berndporr/attys/attys_fw/README.md

# attys_fw

This is the firmware for the Attys.

## Requirements

  - MSP430 Launchpad
  - Linux system
  - mspdebug
  - msp gcc packages

## How to install

  - connect the programmer to the SBW pins
  - type "make"
  - mspdebug rf2500
  - prog attys_fw.elf
