berndporr/attys/attys_hardware/attys_bom.xls

BOM | bt-bio-1.1
 |  | Qty | Value | Device | Package | Parts | Description | Farnell
 |  | 1 |  | MA03-1 | MA03-1 | SV1 | PIN HEADER | 3417657
 |  | 8 | 100nF | C-EUC0603 | C0603 | C1, C3, C5, C6, C9, C10, C13, C28 | CAPACITOR, European symbol | 1759122
 |  | 1 | 10nF | C-EUC0603 | C0603 | C8 | CAPACITOR, European symbol | 1759102
 |  | 7 | 10uF | C-EUC1206 | C1206 | C2, C7, C11, C12, C14, C20, C24 | CAPACITOR, European symbol | 1458919
 |  | 2 | 1uF | C-EUC0603 | C0603 | C15, C16 | CAPACITOR, European symbol | 1759408
 |  | 10 | 2.2K | R-EU_R0603 | R0603 | R2, R10, R12, R13, R16, R17, R18, R19, R21, R22 | RESISTOR, European symbol | 1469765
 |  | 2 | 33K | R-EU_R0603 | R0603 | R1, R20 | RESISTOR, European symbol | 1469801
 |  | 2 | 4.7nF | C-EUC0603 | C0603 | C17, C18 | CAPACITOR, European symbol | 2320809
 |  | 4 | 4.7uF | CPOL-EUSMCC | SMC_C | C23, C25, C26, C27 | POLARIZED CAPACITOR, European symbol | 1754202
 |  | 4 | 47pF | C-EUC0603 | C0603 | C4, C19, C21, C22 | CAPACITOR, European symbol | 1759062
 |  | 1 | 47uH | R-EU_R0805 | R0805 | L1 | RESISTOR, European symbol | 2215655
 |  | 4 | 4MMCONNECT | 4MMCONNECT | 4MMCONNECT | U$5, U$7, U$9, U$10 |  | 1101130
 |  | 5 | 51K | R-EU_R0603 | R0603 | R4, R5, R6, R9, R23 | RESISTOR, European symbol | 2447393
 |  | 2 | 53047-03 | 53047-03 | 53047-03 | X1, X3 | CONNECTOR | 1022276
 |  | 1 | ADP121-AUJZ18R7 | ADP121-AUJZ33R7 | SOT95P280X100-5N | U4 | 150 mA, Low Quiescent Current, CMOS Linear Regulator | 2457162
 |  | 1 | ADP121-AUJZ33R7 | ADP121-AUJZ33R7 | SOT95P280X100-5N | U1 | 150 mA, Low Quiescent Current, CMOS Linear Regulator | 2074869
 |  | 1 | ADS1292RIPBS | ADS1292R | TQFP-32 | ADS1292R |  | 3116601
 |  | 1 | BLUE | LEDCHIPLED_0805 | CHIPLED_0805 | LED1 | LED | 1716765
 |  | 2 | GREEN | LEDCHIPLED_0805 | CHIPLED_0805 | LED5, LED6 | LED | 2112116
 |  | 1 | LM2664/NOPB | LM2664 | SOT-23-5 | U$12 |  | 3123021
 |  | 1 | LSM9DS1 | LSM9DS1 | LGA24-8X4 | U5 | LSM9DS1 3D accelerometer, gyroscope & magnetometer | 2532383
 |  | 1 | MCP73837-FCI/UN | MCP73837 | MSOP10 | U2 |  | 1675426
 |  | 1 | MINI-USB-SHIELD-UX60-MB-5ST | MINI-USB-SHIELD-UX60-MB-5ST | UX60-MB-5ST | X2 | MINI USB Connector | 2293774
 |  | 1 | MSP430G2553 | MSP430G2553 | TSSOP20 | U$4 |  | 2325745
 |  | 1 | RED | LEDCHIPLED_0805 | CHIPLED_0805 | LED2 | LED | 2099241
 |  | 1 | RN42 | Bluetooth module | RN42 | U$3 |  | 2678457
 |  | 1 | TL36YO | TL36YO | TL3XYO | S1 | TINY SWITCH ON - ON | 1550095
 |  | 6 | VDR,4V | R-EU_R0805 | R0805 | R3, R7, R8, R11, R14, R15 | RESISTOR, European symbol | 8832463
 |  | 1 | Vbat | JP1E | JP1 | VBAT | JUMPER | CN09983
