berndporr/attys/attys_hardware/eagle/attys.brd

## EAGLE design attys_hardware/eagle/attys.brd (2026-11-03)

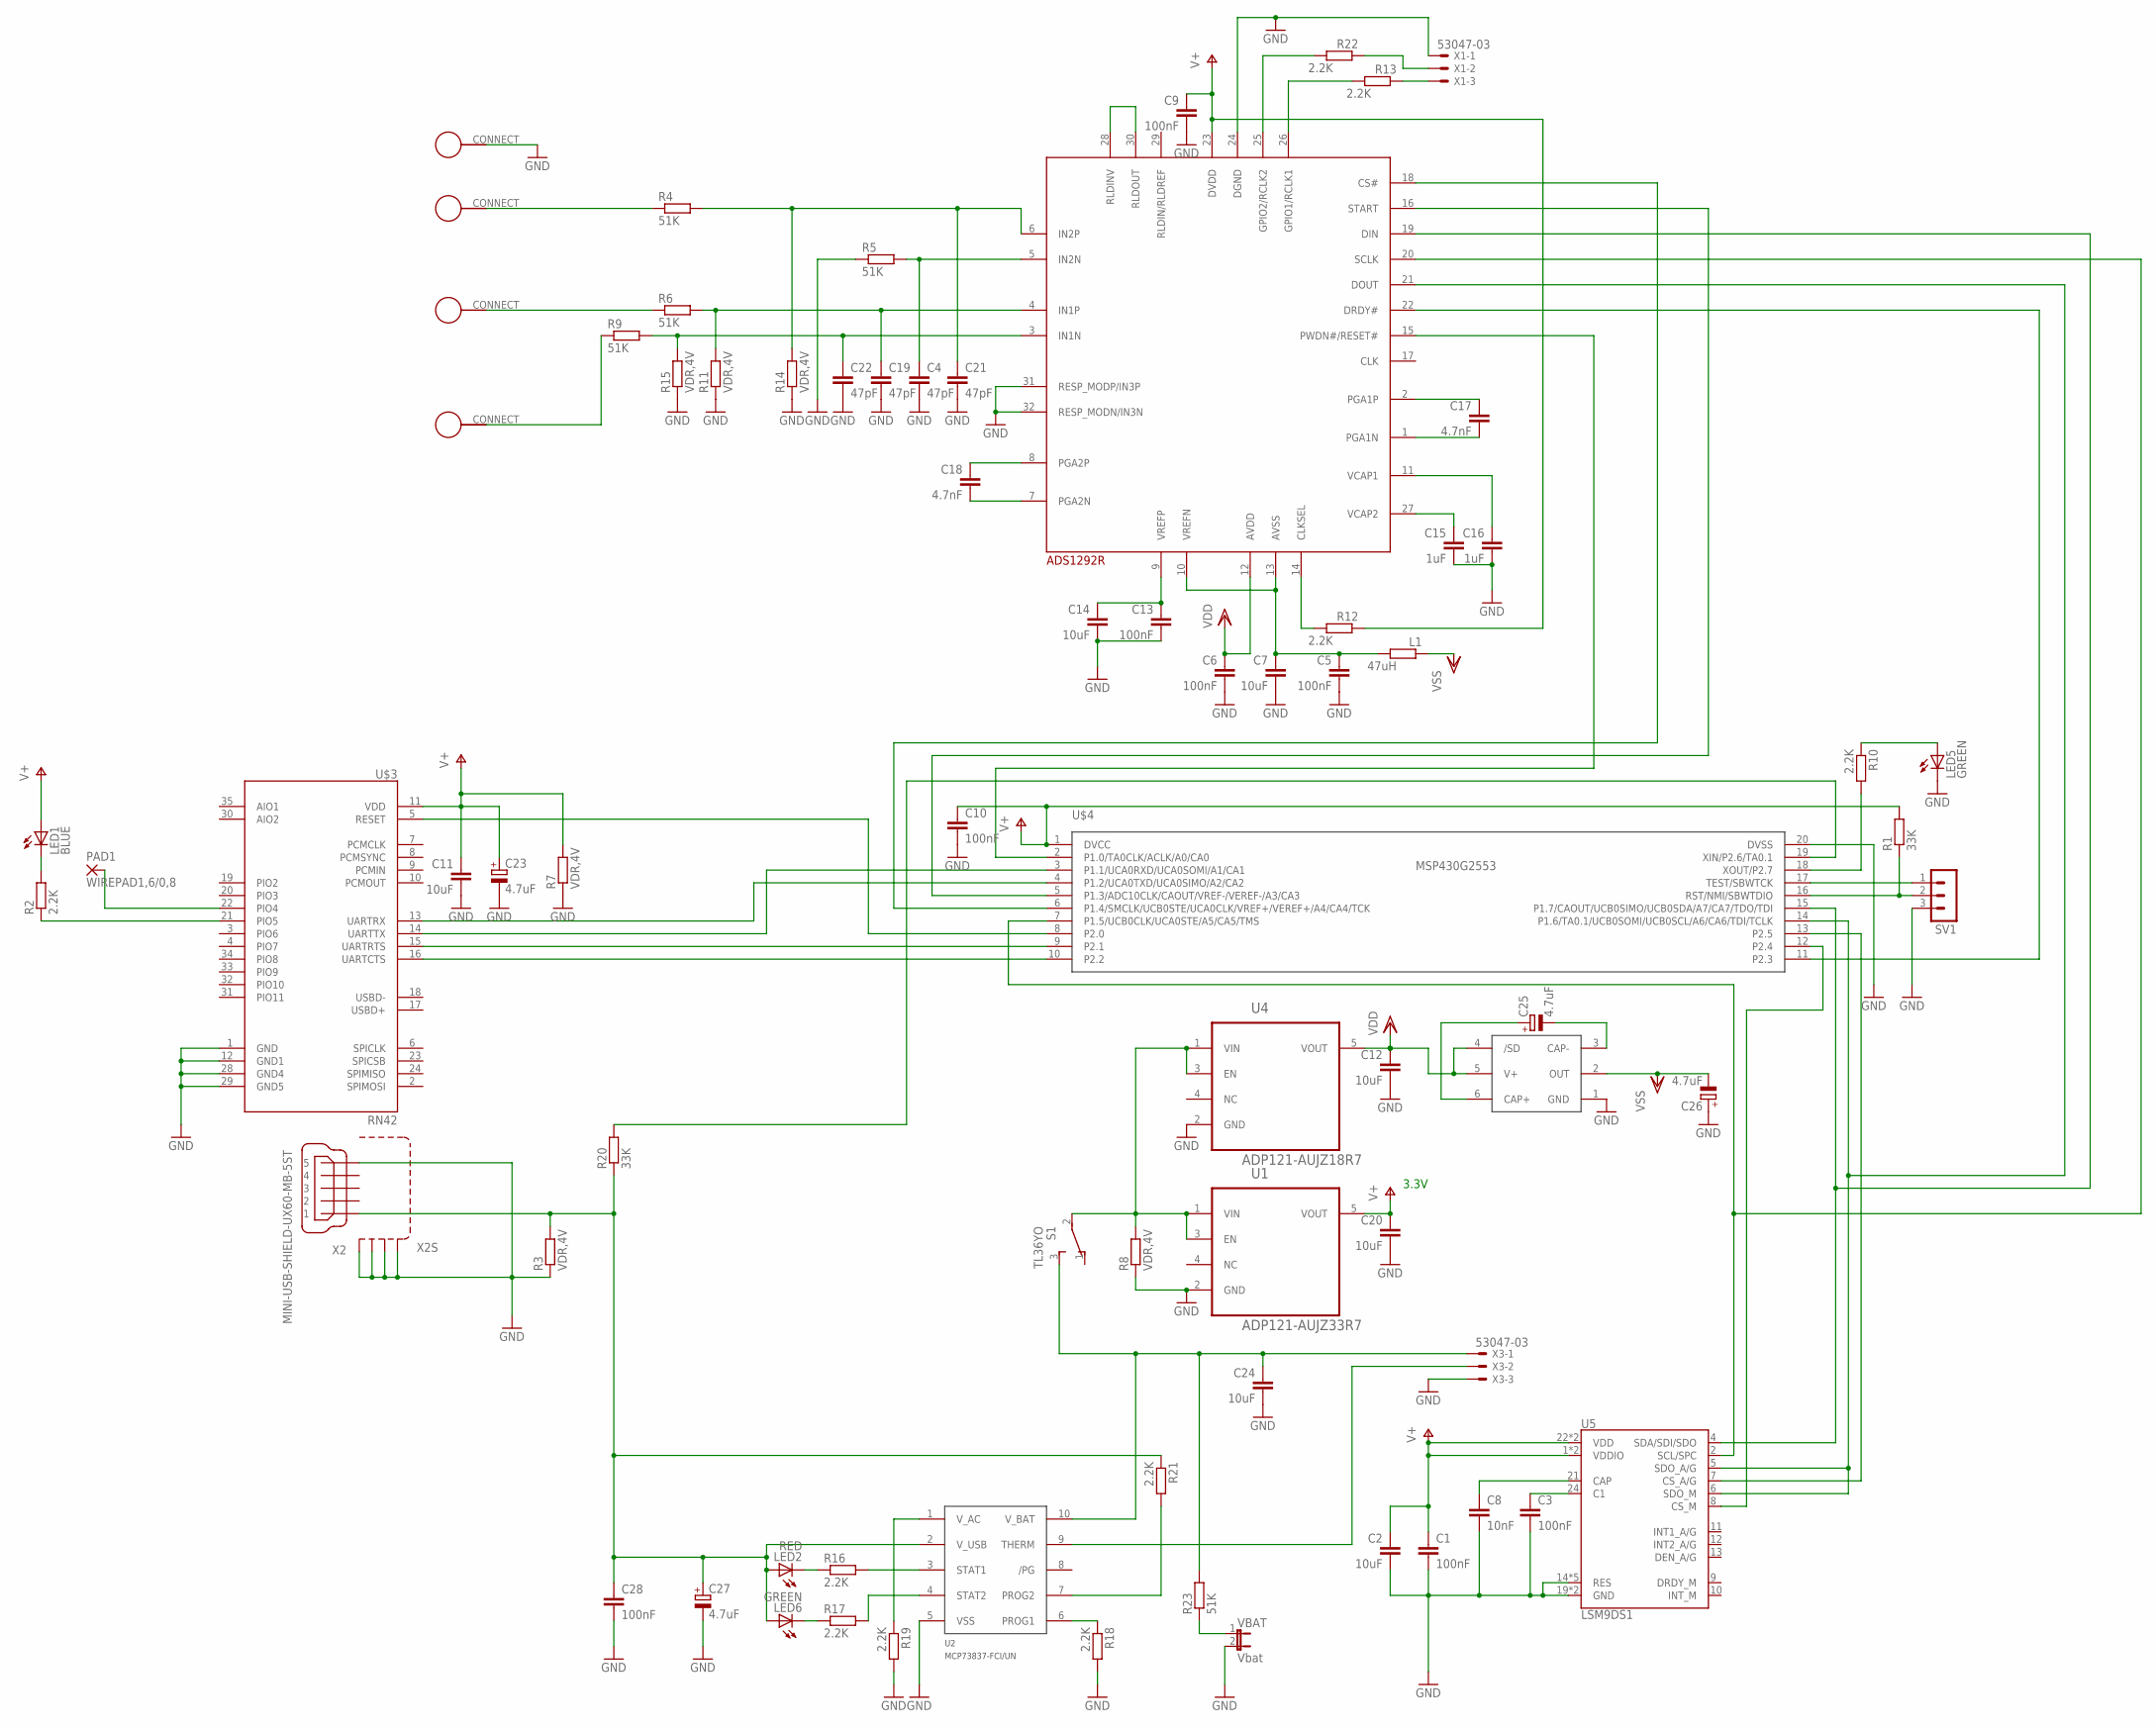
[picture p3: schematic attys.sch]

Parts:
ADS1292R: ADS1292R; TQFP-32
C1, C3, C5, C6, C9, C10, C13, C28: 100nF; C0603
C2, C7, C11, C12, C14, C20, C24: 10uF; C1206
C4, C19, C21, C22: 47pF; C0603
C8: 10nF; C0603
C15, C16: 1uF; C0603
C17, C18: 4.7nF; C0603
C23, C25, C26, C27: 4.7uF; SMC_C
L1: 47uH; R0805
LED1: BLUE; CHIPLED_0805
LED2: RED; CHIPLED_0805
LED5, LED6: GREEN; CHIPLED_0805
PAD1: WIREPAD1,6/0,8; 1,6/0,8
R1, R20: 33K; R0603
R2, R10, R12, R13, R16, R17, R18, R19, R21, R22: 2.2K; R0603
R3, R7, R8, R11, R14, R15: VDR,4V; R0805
R4, R5, R6, R9, R23: 51K; R0603
S1: TL36YO; TL3XYO
SV1: MA03-1
U1: ADP121-AUJZ33R7; SOT95P280X100-5N
U2: MCP73837-FCI/UN; MSOP10
U4: ADP121-AUJZ18R7; SOT95P280X100-5N
U5: LSM9DS1; LGA24-8X4
U$3: RN42; SPARKFUN_RN41
U$4: MSP430G2553; TSSOP20
U$5, U$7, U$9, U$10: 4MMCONNECT
U$12: LM2664; SOT-23-5
VBAT: Vbat; JP1
X1, X3: 53047-03
X2: MINI-USB-SHIELD-UX60-MB-5ST; UX60-MB-5ST

Connections:
+5V: C27.+, C28.1, LED2.A, LED6.A, R3.2, R20.1, R21.1, U2.2 (V_USB), X2.1
CS/: U5.8 (CS_M), U$4.12 (P2.4)
ECG_/CS: ADS1292R.18 (CS#), U$4.6 (P1.4/SMCLK/UCB0STE/UCA0CLK/VREF+/VEREF+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)
ECG_/DRDY: ADS1292R.22 (DRDY#), U$4.11 (P2.3)
ECG_START: ADS1292R.16 (START), U$4.5 (P1.3/ADC10CLK/CAOUT/VREF-/VEREF-/A3/CA3)
GND: ADS1292R.24 (DGND), ADS1292R.31 (RESP_MODP/IN3P), ADS1292R.32 (RESP_MODN/IN3N), C1.2, C2.2, C3.2, C4.2, C5.2, C6.2, C7.2, C8.2, C9.2, C10.2, C11.2, C12.2, C13.2, C14.2, C15.2, C16.2, C19.2, C20.2, C21.2, C22.2, C23.-, C24.2, C26.+, C27.-, C28.2, LED5.C, R3.1, R5.1, R7.1, R8.1, R11.1, R14.1, R15.1, R18.2, R19.2, SV1.3, U1.2 (GND), U2.5 (VSS), U4.2 (GND), U5.14 (RES), U5.15 (RES), U5.16 (RES), U5.17 (RES), U5.18 (RES), U5.19 (GND), U5.20 (GND), U$3.1 (GND), U$3.12 (GND1), U$3.28 (GND4), U$3.29 (GND5), U$4.20 (DVSS), U$5.CONNECT, U$12.1 (GND), VBAT.2, X1.1, X2.5, X2.M1 (S1), X2.M2 (S2), X2.M3 (S3), X2.M4 (S4), X3.3
unnamed: R1.1, SV1.2, U$4.16 (RST/NMI/SBWTDIO)
unnamed: U$3.13 (UARTRX), U$4.4 (P1.2/UCA0TXD/UCA0SIMO/A2/CA2)
unnamed: ADS1292R.28 (RLDINV), ADS1292R.30 (RLDOUT)
unnamed: ADS1292R.5 (IN2N), C4.1, R5.2
unnamed: SV1.1, U$4.17 (TEST/SBWTCK)
unnamed: U$3.14 (UARTTX), U$4.3 (P1.1/UCA0RXD/UCA0SOMI/A1/CA1)
unnamed: U$3.15 (UARTRTS), U$4.9 (P2.1)
unnamed: U$3.16 (UARTCTS), U$4.10 (P2.2)
unnamed: U$3.5 (RESET), U$4.8 (P2.0)
unnamed: R2.1, U$3.21 (PIO5)
unnamed: R8.2, S1.2, U1.1 (VIN), U1.3 (EN), U4.1 (VIN), U4.3 (EN)
unnamed: ADS1292R.10 (VREFN), ADS1292R.13 (AVSS), C5.1, C7.1, L1.2
unnamed: PAD1.1, U$3.22 (PIO4)
unnamed: R10.2, U$4.18 (XOUT/P2.7)
unnamed: LED5.A, R10.1
unnamed: LED1.C, R2.2
unnamed: ADS1292R.25 (GPIO2/RCLK2), R22.2
unnamed: ADS1292R.9 (VREFP), C13.1, C14.1
unnamed: ADS1292R.27 (VCAP2), C15.1
unnamed: ADS1292R.26 (GPIO1/RCLK1), R13.2
unnamed: ADS1292R.11 (VCAP1), C16.1
unnamed: R20.2, U$4.19 (XIN/P2.6/TA0.1)
unnamed: ADS1292R.15 (PWDN#/RESET#), U$4.2 (P1.0/TA0CLK/ACLK/A0/CA0)
unnamed: U5.7 (CS_A/G), U$4.13 (P2.5)
unnamed: C3.1, U5.24 (C1)
unnamed: C8.1, U5.21 (CAP)
unnamed: R13.1, X1.3
unnamed: R22.1, X1.2
unnamed: R23.1, VBAT.1
unnamed: ADS1292R.2 (PGA1P), C17.1
unnamed: ADS1292R.1 (PGA1N), C17.2
unnamed: ADS1292R.8 (PGA2P), C18.1
unnamed: ADS1292R.7 (PGA2N), C18.2
unnamed: ADS1292R.14 (CLKSEL), R12.2
unnamed: ADS1292R.6 (IN2P), C21.1, R4.2, R14.2
unnamed: ADS1292R.3 (IN1N), C22.1, R9.2, R15.2
unnamed: ADS1292R.4 (IN1P), C19.1, R6.2, R11.2
unnamed: R4.1, U$7.CONNECT
unnamed: R9.1, U$10.CONNECT
unnamed: R6.1, U$9.CONNECT
unnamed: C24.1, R23.2, S1.3 (S), U2.10 (V_BAT), X3.1
unnamed: C25.+, U$12.6 (CAP+)
unnamed: C25.-, U$12.3 (CAP-)
unnamed: R16.2, U2.3 (STAT1)
unnamed: LED6.C, R17.1
unnamed: R17.2, U2.4 (STAT2)
unnamed: LED2.C, R16.1
unnamed: R18.1, U2.6 (PROG1)
unnamed: U2.9 (THERM), X3.2
unnamed: R19.1, U2.1 (V_AC)
unnamed: R21.2, U2.7 (PROG2)
SPI_CLK: ADS1292R.20 (SCLK), U5.2 (SCL/SPC), U$4.7 (P1.5/UCB0CLK/UCA0STE/A5/CA5/TMS)
SPI_MISO: ADS1292R.21 (DOUT), U5.5 (SDO_A/G), U5.6 (SDO_M), U$4.14 (P1.6/TA0.1/UCB0SOMI/UCB0SCL/A6/CA6/TDI/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)
SPI_MOSI: ADS1292R.19 (DIN), U5.4 (SDA/SDI/SDO), U$4.15 (P1.7/CAOUT/UCB0SIMO/UCB0SDA/A7/CA7/TDO/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)
V+: ADS1292R.23 (DVDD), C1.1, C2.1, C9.1, C10.1, C11.1, C20.1, C23.+, LED1.A, R1.2, R7.2, R12.1, U1.5 (VOUT), U5.1 (VDDIO), U5.3 (VDDIO), U5.22 (VDD), U5.23 (VDD), U$3.11 (VDD), U$4.1 (DVCC)
VDD: ADS1292R.12 (AVDD), C6.1, C12.1, U4.5 (VOUT), U$12.4 (/SD), U$12.5 (V+)
VSS: C26.-, L1.1, U$12.2 (OUT)

Notes on the sheet:
3.3V

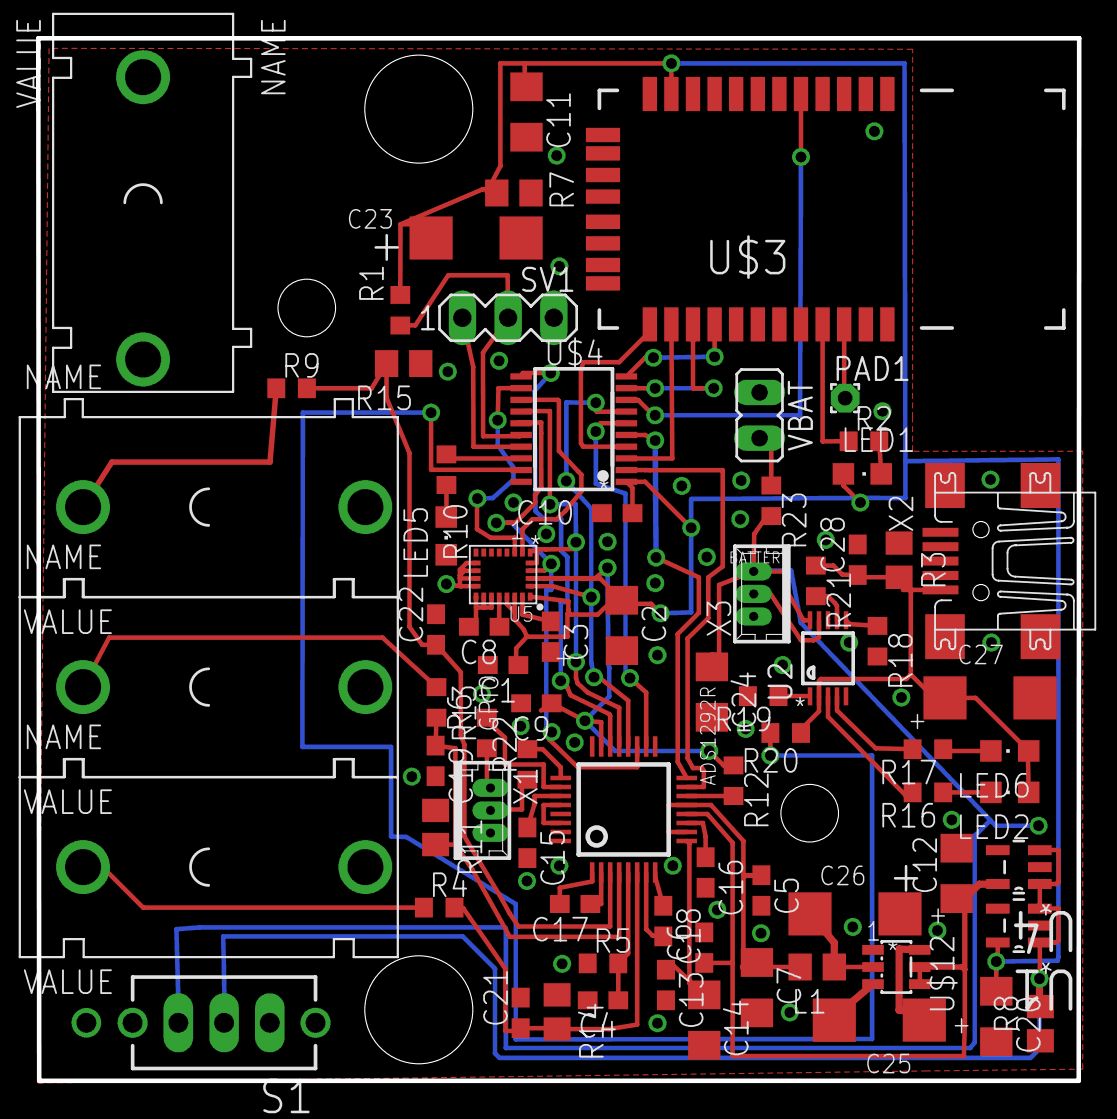
[picture p4: board attys.brd from above]

Board: 2 copper layers, 57.8 x 57.9 mm, 75 parts (0 on the bottom side), 63 nets.
