berndporr/attys/(commit log)

2026-11-03 Converted to kicad
    [attys.brd, attys.kicad_pcb, attys.kicad_sch, attys.sch, attys_bom.ods, attys_bom.xls]
2026-11-09 Moved BOM back into the main folder.
    [attys_bom.xls]
